gowthamdakshnamoorthy/PARA-Lab-Works/(commit log)

2022-04-27 Updated on Raspberry Pi code for NEMA-17
2022-05-15 Code for demo 1 trial run
    This code is good for the actuators and the dc motors, but not for the NEMA-17 stepper motor
2022-06-14 Arduino Code for 5V stepper motor
    Do not change the base speed configuration, need to be altered to Raspberry Pi
2022-07-23 Modified for 5V stepper motor
2022-08-10 Updated for DC Motors
    Need to be updated and refined for Stepper Motor
2022-08-10 Updated for Stepper Motor
    Need to be debugged and trial tested
